astromaf/Sonda-EPM_1/Captura de pantalla 2013-12-08 a las 15.16.57.png

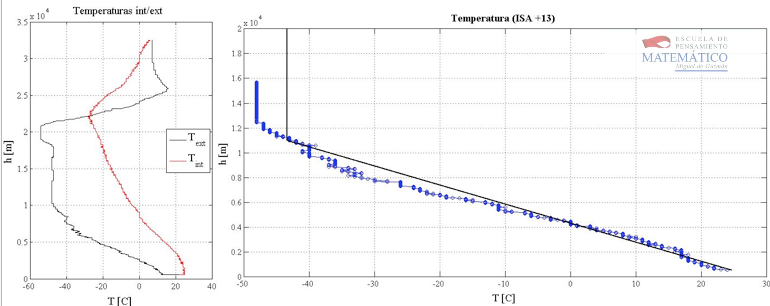
Captura de pantalla 2013-12-08 a las 15.16.57.png
