astromaf/Sonda-EPM_1/Comp.modelos.jpg

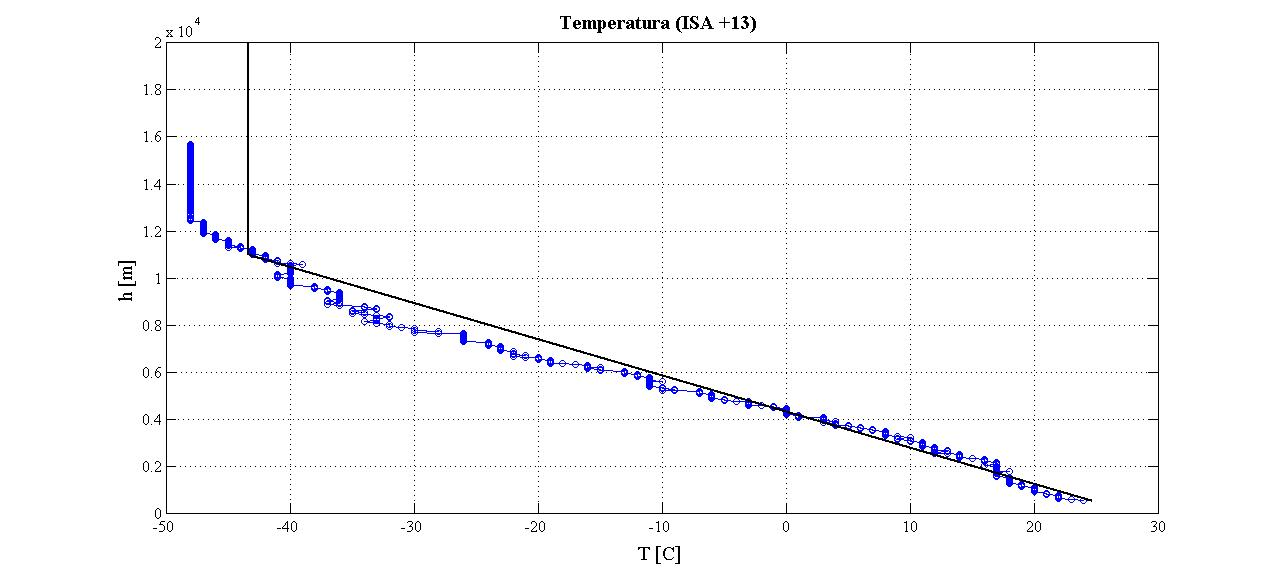
Comp.modelos.jpg
