astromaf/Sonda-EPM_1/perfilAlturas.jpg

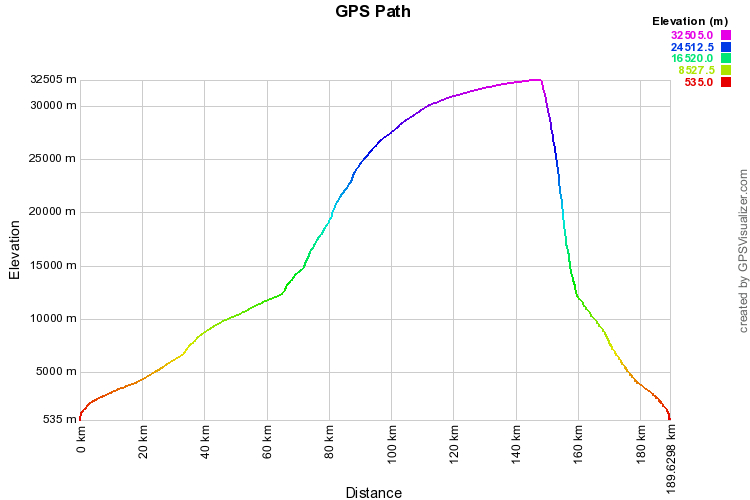
perfilAlturas.jpg
