astromaf/Sonda-EPM_1/EPMv1_firmware/InterrGPS.pde

void gpslogger(){

  if (GPS.LOCUS_StartLogger()){
    Serial.println("GPS STARTED!");
  }
  else{
    Serial.println("no response");
    
    for(int i=0;i<10;i++){
    digitalWrite(led2, HIGH); 
    delay(200);  
    digitalWrite(led2, LOW); 
    delay(200);  
    }
    gpslogger();
  }

}


/******************************************************************/

// Interrupt is called once a millisecond, looks for any new GPS data, and stores it
SIGNAL(TIMER0_COMPA_vect) {
  char c = GPS.read();
  // if you want to debug, this is a good time to do it!
  if (GPSECHO && c) {
#ifdef UDR0
    UDR0 = c;  
    // writing direct to UDR0 is much much faster than Serial.print 
    // but only one character can be written at a time. 
#endif
  }
}

void useInterrupt(boolean v) {
  if (v) {
    // Timer0 is already used for millis() - we'll just interrupt somewhere
    // in the middle and call the "Compare A" function above
    OCR0A = 0xAF;
    TIMSK0 |= _BV(OCIE0A);
    usingInterrupt = true;
  } else {
    // do not call the interrupt function COMPA anymore
    TIMSK0 &= ~_BV(OCIE0A);
    usingInterrupt = false;
  }
}
