astromaf/Sonda-EPM_1/(commit log)

2013-12-08 Manual de operación
2014-05-19 More data form the EEPROM memory
    [EPM1.xlsx]
